boldx/edid-nuzzler/hw/edid_nuzzler.kicad_pcb

## KiCad design hw/edid_nuzzler.kicad_pcb (2025-06-19)

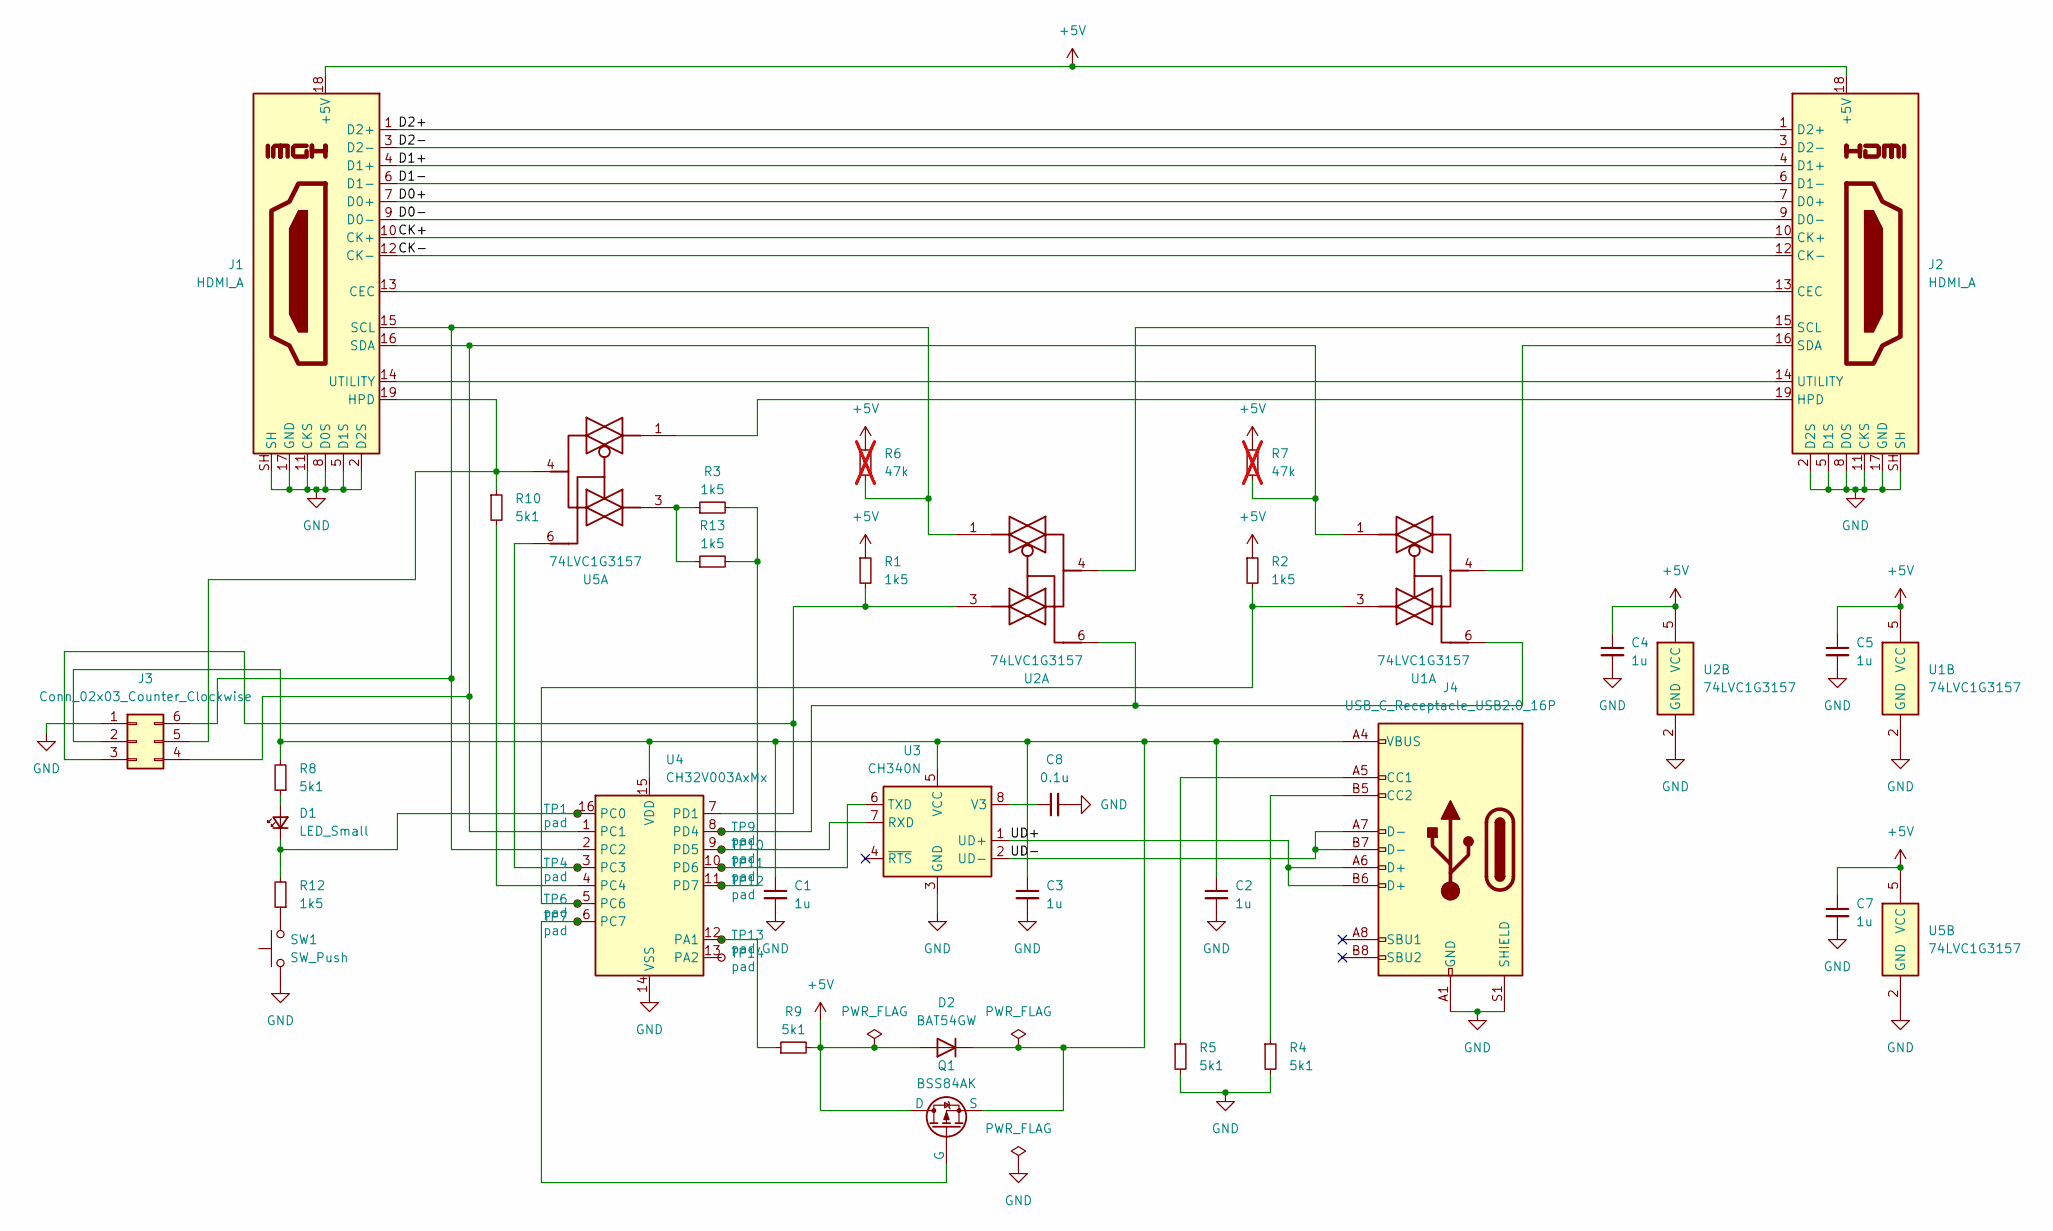
[picture p1: schematic edid_nuzzler.kicad_sch]

Parts:
C1, C2, C3, C4, C5, C7: 1u; C_0603_1608Metric_Pad1.08x0.95mm_HandSolder
C8: 0.1u; C_0603_1608Metric_Pad1.08x0.95mm_HandSolder
D1: LED_Small; LED_0603_1608Metric_Pad1.05x0.95mm_HandSolder
D2: BAT54GW; D_SOD-123
J1, J2: HDMI_A; HDMI_A_Molex_208658-1001_Horizontal
J3: Conn_02x03_Counter_Clockwise; PinHeader_2x03_P2.54mm_Vertical
J4: USB_C_Receptacle_USB2.0_16P; USB_C_Receptacle_G-Switch_GT-USB-7010ASV
Q1: BSS84AK; SOT-23
R1, R2, R3, R12, R13: 1k5; R_0603_1608Metric_Pad0.98x0.95mm_HandSolder
R4, R5, R8, R9, R10: 5k1; R_0603_1608Metric_Pad0.98x0.95mm_HandSolder
R6, R7: 47k; R_0603_1608Metric_Pad0.98x0.95mm_HandSolder; not fitted
SW1: SW_Push; SW_XKB_TS-1101-C-W
TP1, TP4, TP6, TP7, TP9, TP10, TP11, TP12, TP13, TP14: pad; TestPoint_Pad_D1.0mm
U1, U2, U5: 74LVC1G3157; SOT-363_SC-70-6_Handsoldering
U3: CH340N; SOP-8_3.9x4.9mm_P1.27mm
U4: CH32V003AxMx; SOP-16_3.9x9.9mm_P1.27mm

Connections:
+5V: C4.1, C5.1, C7.1, D2.2 (A), J1.18 (+5V), J2.18 (+5V), Q1.1 (D), R1.1, R2.1, R6.1, R7.1, R9.2, U1.5 (VCC), U2.5 (VCC), U5.5 (VCC)
/CK+: J1.10 (CK+), J2.10 (CK+)
/CK-: J1.12 (CK-), J2.12 (CK-)
/D0+: J1.7 (D0+), J2.7 (D0+)
/D0-: J1.9 (D0-), J2.9 (D0-)
/D1+: J1.4 (D1+), J2.4 (D1+)
/D1-: J1.6 (D1-), J2.6 (D1-)
/D2+: J1.1 (D2+), J2.1 (D2+)
/D2-: J1.3 (D2-), J2.3 (D2-)
/UD+: J4.A6 (D+), J4.B6 (D+), U3.1 (UD+)
/UD-: J4.A7 (D-), J4.B7 (D-), U3.2 (UD-)
GND: C1.2, C2.2, C3.2, C4.2, C5.2, C7.2, C8.2, J1.2 (D2S), J1.5 (D1S), J1.8 (D0S), J1.11 (CKS), J1.17 (GND), J1.SH, J2.2 (D2S), J2.5 (D1S), J2.8 (D0S), J2.11 (CKS), J2.17 (GND), J2.SH, J3.1, J4.A1 (GND), J4.A12 (GND), J4.B1 (GND), J4.B12 (GND), J4.S1 (SHIELD), R4.2, R5.2, SW1.1, U1.2 (GND), U2.2 (GND), U3.3 (GND), U4.14 (VSS), U5.2 (GND)
unnamed: D1.2 (A), R8.1
unnamed: D1.1 (K), R12.2, TP1.1, U4.16 (PC0)
unnamed: C1.1, C2.1, C3.1, D2.1 (K), J3.2, J4.A4 (VBUS), J4.A9 (VBUS), J4.B4 (VBUS), J4.B9 (VBUS), Q1.3 (S), R8.2, U3.5 (VCC), U4.15 (VDD)
unnamed: J1.13 (CEC), J2.13 (CEC)
unnamed: J1.19 (HPD), J3.5, R10.1, U5.4
unnamed: J1.15 (SCL), J3.6, R6.2, U2.1, U4.2 (PC2)
unnamed: J1.16 (SDA), J3.4, R7.2, U1.1, U4.1 (PC1)
unnamed: J1.14 (UTILITY), J2.14 (UTILITY)
unnamed: J2.19 (HPD), U5.1
unnamed: J2.15 (SCL), U2.4
unnamed: J2.16 (SDA), U1.4
unnamed: J3.3, R1.2, U2.3, U4.7 (PD1)
unnamed: J4.A5 (CC1), R5.1
unnamed: J4.B5 (CC2), R4.1
unnamed: Q1.2 (G), TP7.1, U4.6 (PC7)
unnamed: R12.1, SW1.2
unnamed: R3.1, R13.1, U5.3
unnamed: TP10.1, U3.7 (RXD), U4.9 (PD5)
unnamed: TP11.1, U3.6 (TXD), U4.10 (PD6)
unnamed: C8.1, U3.8 (V3)
unnamed: R9.1, TP13.1, U4.12 (PA1)
unnamed: TP14.1, U4.13 (PA2)
unnamed: TP4.1, U4.3 (PC3), U5.6
unnamed: R10.2, U4.4 (PC4)
unnamed: R2.2, TP6.1, U1.3, U4.5 (PC6)
unnamed: TP9.1, U1.6, U2.6, U4.8 (PD4)
unnamed: R3.2, R13.2, TP12.1, U4.11 (PD7)

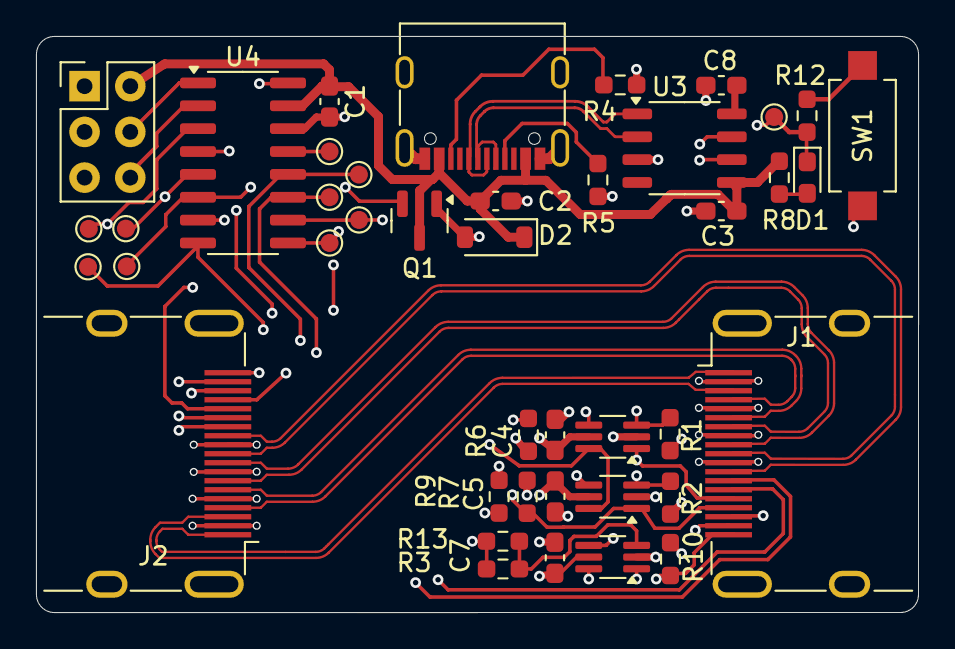
[picture p2: board edid_nuzzler.kicad_pcb from above]

Board: 4 copper layers, 49.0 x 32.0 mm, 42 parts (0 on the bottom side), 39 nets.
