boldx/edid-nuzzler/(commit log)

2025-05-24 Corase layout
    [edid_nuzzler.kicad_pcb, edid_nuzzler.kicad_sch]
2025-05-25 Hopefully better high speed layout
    [edid_nuzzler.kicad_pcb]
2025-06-01 PCB wip
    [edid_nuzzler.kicad_pcb]
2025-06-01 Rough idea about routing
    [edid_nuzzler.kicad_pcb, edid_nuzzler.kicad_sch]
2025-06-01 trace cleanup
    [edid_nuzzler.kicad_pcb]
2025-06-07 Mostly done
    [edid_nuzzler.kicad_pcb]
2025-06-19 v1.0 HW as sent to fab
    [edid_nuzzler.kicad_pcb, full_bom.csv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]
2025-06-23 Sync J3 sch symbol numbering order with the pcb footprint
    [edid_nuzzler.kicad_sch]
2025-07-05 Basic operations: get/set/store EDID data, get/set HPD pin state
